ahmedddmohh/ATmega32-Based-Washing-Machine-Controller/Pro.png

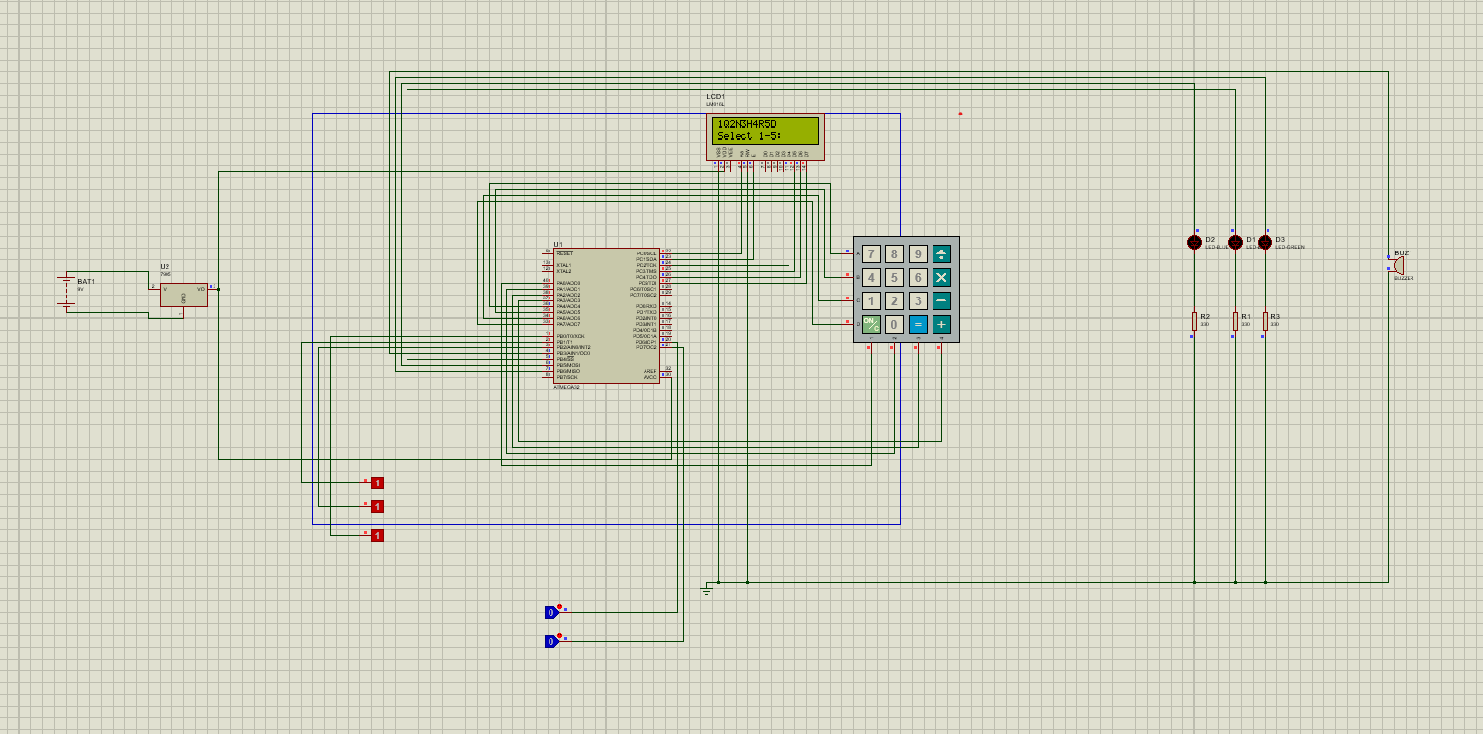
Pro.png
