ahmedddmohh/ATmega32-Based-Washing-Machine-Controller/(list of files, drawings)

Other design files:
Final Prototype.pdsprj
New Project.pdsprj
